davidorlian/smart-shabbat-clock/firmware/Smart_Shabbat_Clock/wifi_config.example.h

#ifndef WIFI_CONFIG_H
#define WIFI_CONFIG_H

// Copy this file to wifi_config.h and set local credentials there.
// wifi_config.h is gitignored and must not be committed.
#define WIFI_SSID "YOUR_SSID_HERE"
#define WIFI_PASSWORD "YOUR_PASSWORD_HERE"

#endif // WIFI_CONFIG_H
