davidorlian/smart-shabbat-clock/(commit log)

2026-01-16 Add Smart Shabbat Clock firmware (ESP32 Arduino)
2026-05-14 Restore LCD pages and power recovery behavior
